Isoheptane/STM32F407V-Dev/board/STM32F407Dev.kicad_pcb

## KiCad design board/STM32F407Dev.kicad_pcb (2025-10-26)

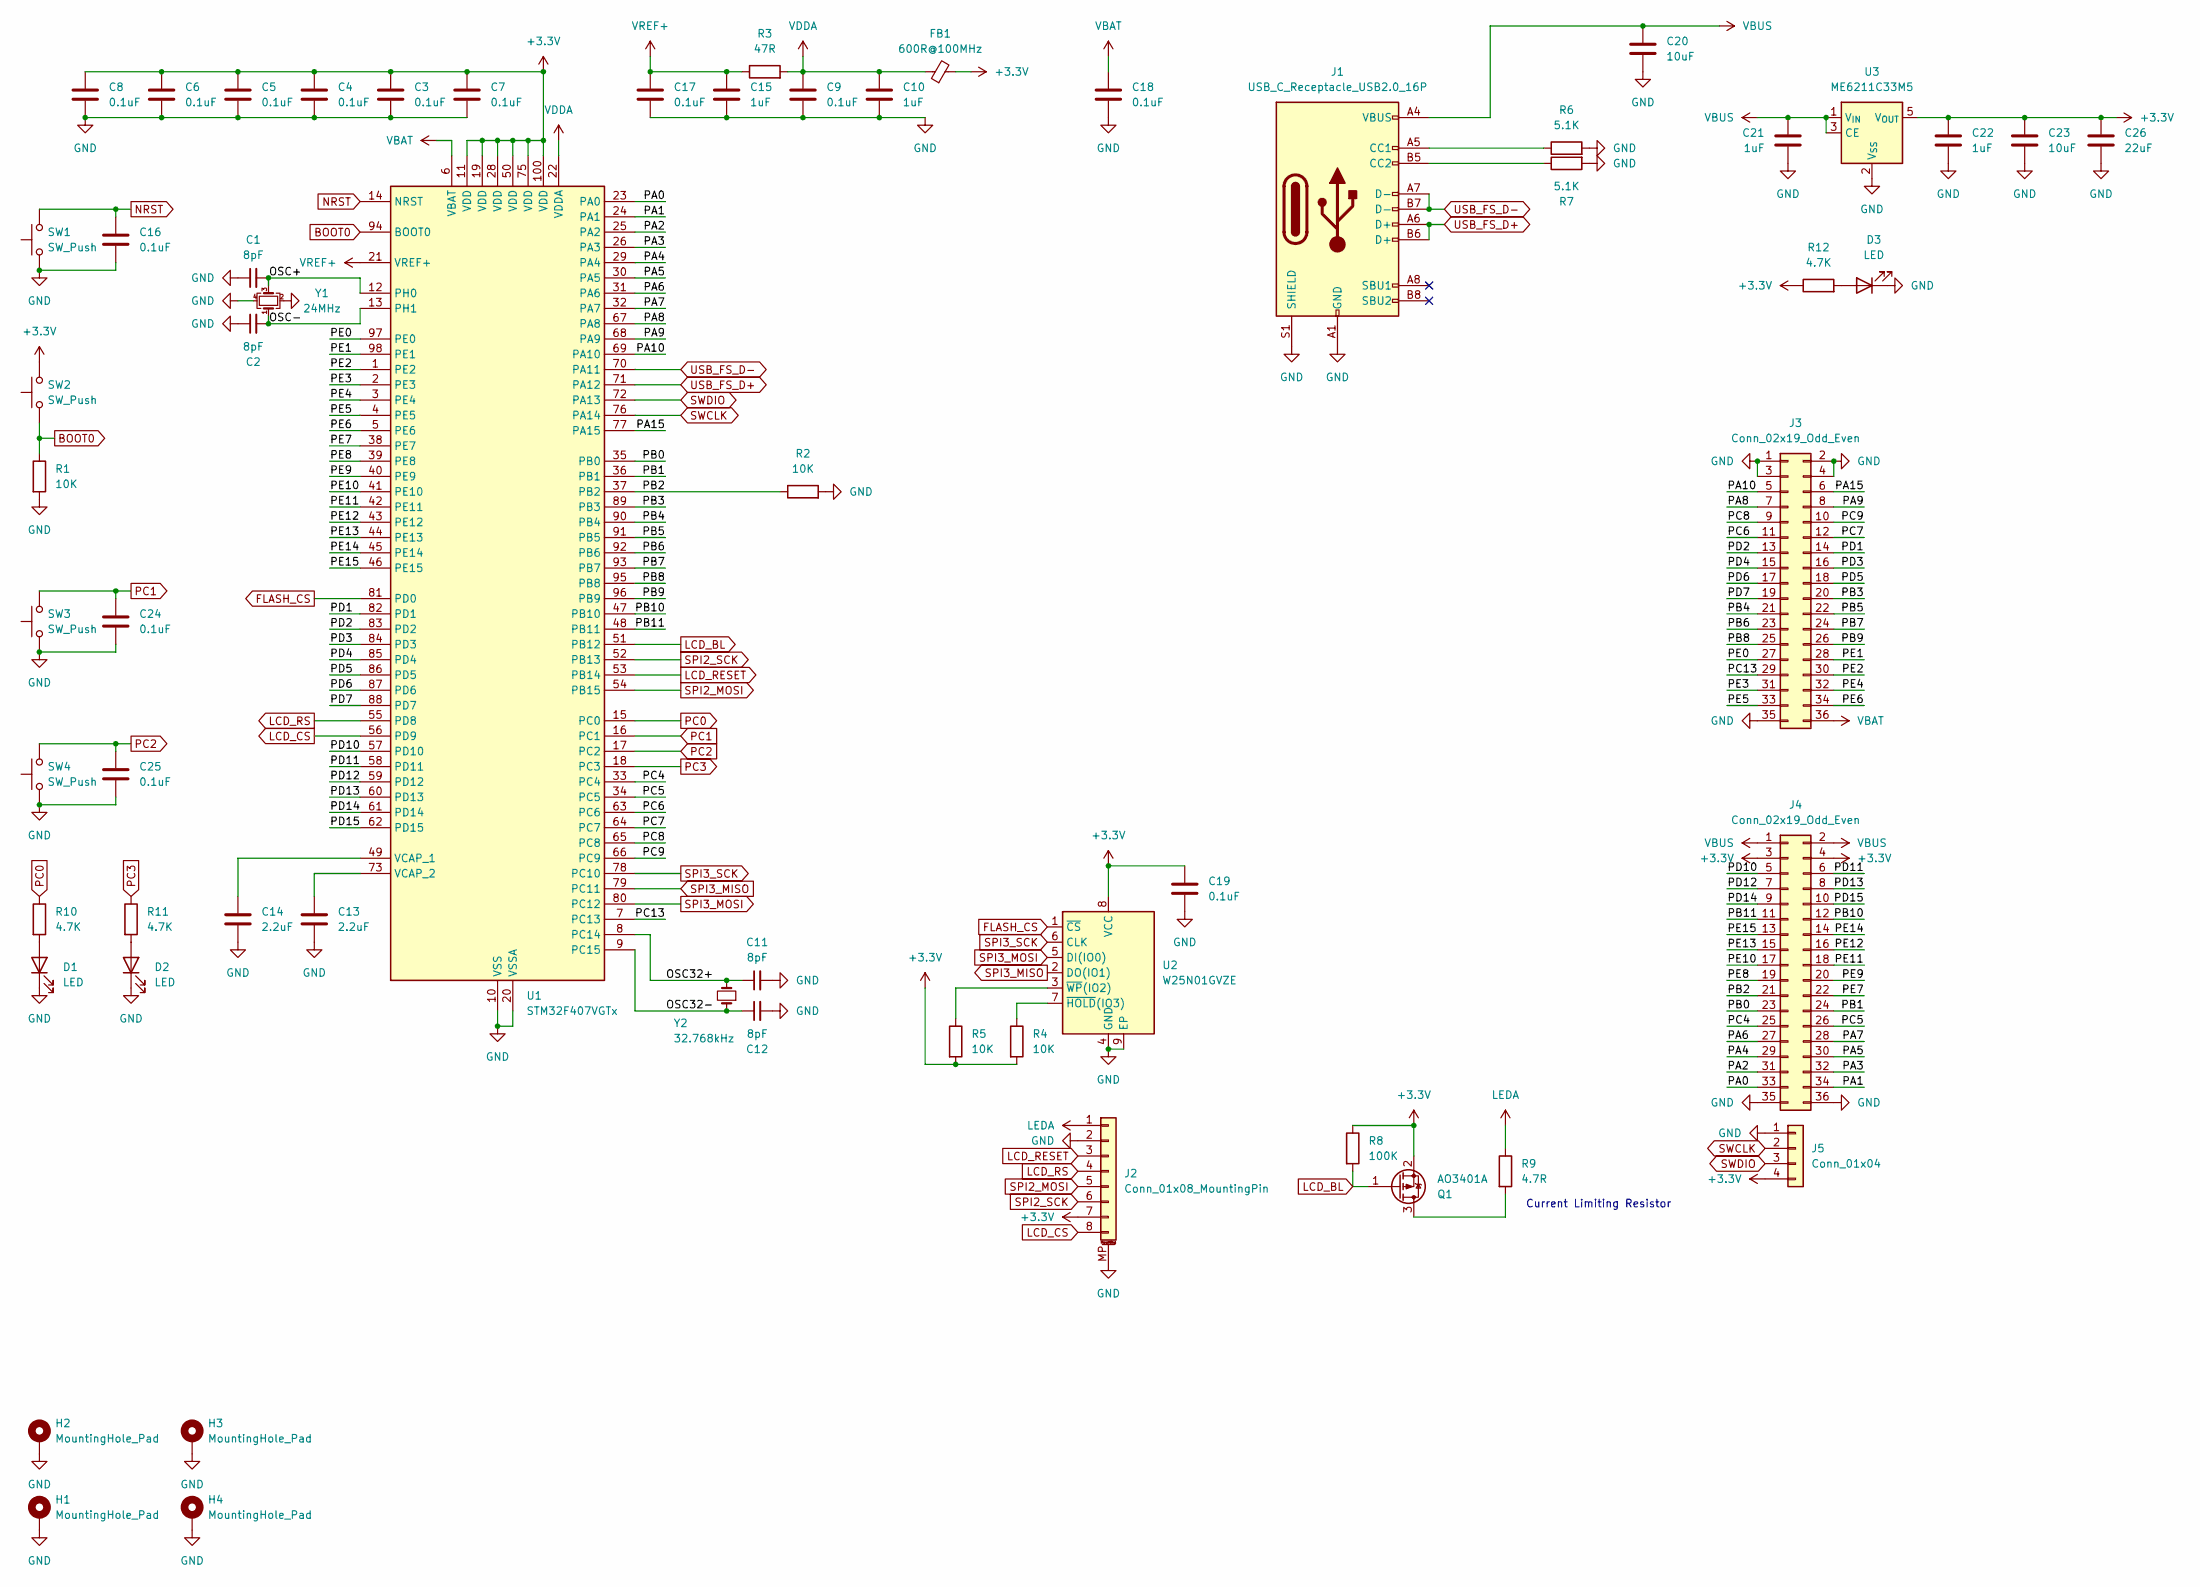
[picture p1: schematic STM32F407Dev.kicad_sch]

Parts:
C1, C2, C11, C12: 8pF; C_0402_1005Metric
C3, C4, C5, C6, C7, C8, C9, C16, C17, C18, C19, C24, C25: 0.1uF; C_0402_1005Metric
C10, C15: 1uF; C_0402_1005Metric
C13, C14: 2.2uF; C_0402_1005Metric
C20, C23: 10uF; C_0805_2012Metric
C21, C22: 1uF; C_0603_1608Metric
C26: 22uF; C_0805_2012Metric
D1, D2, D3: LED; LED_0603_1608Metric
FB1: 600R@100MHz; L_0603_1608Metric
H1, H2, H3, H4: MountingHole_Pad; MountingHole_2.2mm_M2_ISO7380_Pad
J1: USB_C_Receptacle_USB2.0_16P; USB_C_Receptacle_GCT_USB4105-xx-A_16P_TopMnt_Horizontal
J2: Conn_01x08_MountingPin; Hirose_FH12-8S-0.5SH_1x08-1MP_P0.50mm_Horizontal
J3, J4: Conn_02x19_Odd_Even; PinHeader_2x18_P2.54mm_Vertical
J5: Conn_01x04; PinHeader_1x04_P2.54mm_Vertical
Q1: AO3401A; SOT-23
R1, R2, R4, R5: 10K; R_0402_1005Metric
R3: 47R; R_0402_1005Metric
R6, R7: 5.1K; R_0402_1005Metric
R8: 100K; R_0402_1005Metric
R9: 4.7R; R_0402_1005Metric
R10, R11, R12: 4.7K; R_0402_1005Metric
SW1, SW2, SW3, SW4: SW_Push; SW_SPST_PTS810
U1: STM32F407VGTx; LQFP-100_14x14mm_P0.5mm
U2: W25N01GVZE; WSON-8-1EP_8x6mm_P1.27mm_EP3.4x4.3mm_WidePin
U3: ME6211C33M5; SOT-23-5
Y1: 24MHz; Crystal_SMD_3225-4Pin_3.2x2.5mm
Y2: 32.768kHz; Crystal_SMD_3215-2Pin_3.2x1.5mm

Connections:
+3.3V: C3.1, C4.1, C5.1, C6.1, C7.1, C8.1, C19.1, C22.1, C23.1, C26.1, FB1.2, J2.7, J4.3, J4.4, J5.4, Q1.2 (S), R4.2, R5.2, R8.1, R12.1, SW2.2, U1.11 (VDD), U1.19 (VDD), U1.28 (VDD), U1.50 (VDD), U1.75 (VDD), U1.100 (VDD), U2.8 (VCC), U3.5 (V_{OUT})
/OSC32+: C11.1, U1.8 (PC14), Y2.2
/OSC32-: C12.1, U1.9 (PC15), Y2.1
/OSC+: C1.2, U1.12 (PH0), Y1.3
/OSC-: C2.2, U1.13 (PH1), Y1.1
/PA0: J4.33, U1.23 (PA0)
/PA1: J4.34, U1.24 (PA1)
/PA2: J4.31, U1.25 (PA2)
/PA3: J4.32, U1.26 (PA3)
/PA4: J4.29, U1.29 (PA4)
/PA5: J4.30, U1.30 (PA5)
/PA6: J4.27, U1.31 (PA6)
/PA7: J4.28, U1.32 (PA7)
/PA8: J3.7, U1.67 (PA8)
/PA9: J3.8, U1.68 (PA9)
/PA10: J3.5, U1.69 (PA10)
/PA15: J3.6, U1.77 (PA15)
/PB0: J4.23, U1.35 (PB0)
/PB1: J4.24, U1.36 (PB1)
/PB2: J4.21, R2.1, U1.37 (PB2)
/PB3: J3.20, U1.89 (PB3)
/PB4: J3.21, U1.90 (PB4)
/PB5: J3.22, U1.91 (PB5)
/PB6: J3.23, U1.92 (PB6)
/PB7: J3.24, U1.93 (PB7)
/PB8: J3.25, U1.95 (PB8)
/PB9: J3.26, U1.96 (PB9)
/PB10: J4.12, U1.47 (PB10)
/PB11: J4.11, U1.48 (PB11)
/PC4: J4.25, U1.33 (PC4)
/PC5: J4.26, U1.34 (PC5)
/PC6: J3.11, U1.63 (PC6)
/PC7: J3.12, U1.64 (PC7)
/PC8: J3.9, U1.65 (PC8)
/PC9: J3.10, U1.66 (PC9)
/PC13: J3.29, U1.7 (PC13)
/PD1: J3.14, U1.82 (PD1)
/PD2: J3.13, U1.83 (PD2)
/PD3: J3.16, U1.84 (PD3)
/PD4: J3.15, U1.85 (PD4)
/PD5: J3.18, U1.86 (PD5)
/PD6: J3.17, U1.87 (PD6)
/PD7: J3.19, U1.88 (PD7)
/PD10: J4.5, U1.57 (PD10)
/PD11: J4.6, U1.58 (PD11)
/PD12: J4.7, U1.59 (PD12)
/PD13: J4.8, U1.60 (PD13)
/PD14: J4.9, U1.61 (PD14)
/PD15: J4.10, U1.62 (PD15)
/PE0: J3.27, U1.97 (PE0)
/PE1: J3.28, U1.98 (PE1)
/PE2: J3.30, U1.1 (PE2)
/PE3: J3.31, U1.2 (PE3)
/PE4: J3.32, U1.3 (PE4)
/PE5: J3.33, U1.4 (PE5)
/PE6: J3.34, U1.5 (PE6)
/PE7: J4.22, U1.38 (PE7)
/PE8: J4.19, U1.39 (PE8)
/PE9: J4.20, U1.40 (PE9)
/PE10: J4.17, U1.41 (PE10)
/PE11: J4.18, U1.42 (PE11)
/PE12: J4.16, U1.43 (PE12)
/PE13: J4.15, U1.44 (PE13)
/PE14: J4.14, U1.45 (PE14)
/PE15: J4.13, U1.46 (PE15)
BOOT0: R1.1, SW2.1, U1.94 (BOOT0)
FLASH_CS: U1.81 (PD0), U2.1 (~CS)
GND: C1.1, C2.1, C3.2, C4.2, C5.2, C6.2, C7.2, C8.2, C9.2, C10.2, C11.2, C12.2, C13.2, C14.2, C15.2, C16.2, C17.2, C18.2, C19.2, C20.2, C21.2, C22.2, C23.2, C24.2, C25.2, C26.2, D1.1 (K), D2.1 (K), D3.1 (K), H1.1, H2.1, H3.1, H4.1, J1.A1 (GND), J1.A12 (GND), J1.B1 (GND), J1.B12 (GND), J1.S1 (SHIELD), J2.2, J2.MP (MountPin), J3.1, J3.2, J3.3, J3.4, J3.35, J4.35, J4.36, J5.1, R1.2, R2.2, R6.2, R7.2, SW1.1, SW3.1, SW4.1, U1.10 (VSS), U1.20 (VSSA), U1.27 (VSS), U1.74 (VSS), U1.99 (VSS), U2.4 (GND), U2.9 (EP), U3.2 (V_{SS}), Y1.2, Y1.4
LCD_BL: Q1.1 (G), R8.2, U1.51 (PB12)
LCD_CS: J2.8, U1.56 (PD9)
LCD_RESET: J2.3, U1.53 (PB14)
LCD_RS: J2.4, U1.55 (PD8)
LEDA: J2.1, R9.1
NRST: C16.1, SW1.2, U1.14 (NRST)
unnamed: D1.2 (A), R10.2
unnamed: D2.2 (A), R11.2
unnamed: D3.2 (A), R12.2
unnamed: J1.A5 (CC1), R6.1
unnamed: J1.B5 (CC2), R7.1
unnamed: Q1.3 (D), R9.2
unnamed: C14.1, U1.49 (VCAP_1)
unnamed: C13.1, U1.73 (VCAP_2)
unnamed: R4.1, U2.7 (~HOLD(IO3))
unnamed: R5.1, U2.3 (~WP(IO2))
PC0: R10.1, U1.15 (PC0)
PC1: C24.1, SW3.2, U1.16 (PC1)
PC2: C25.1, SW4.2, U1.17 (PC2)
PC3: R11.1, U1.18 (PC3)
SPI2_MOSI: J2.5, U1.54 (PB15)
SPI2_SCK: J2.6, U1.52 (PB13)
SPI3_MISO: U1.79 (PC11), U2.2 (DO(IO1))
SPI3_MOSI: U1.80 (PC12), U2.5 (DI(IO0))
SPI3_SCK: U1.78 (PC10), U2.6 (CLK)
SWCLK: J5.2, U1.76 (PA14)
SWDIO: J5.3, U1.72 (PA13)
USB_FS_D+: J1.A6 (D+), J1.B6 (D+), U1.71 (PA12)
USB_FS_D-: J1.A7 (D-), J1.B7 (D-), U1.70 (PA11)
VBAT: C18.1, J3.36, U1.6 (VBAT)
VBUS: C20.1, C21.1, J1.A4 (VBUS), J1.A9 (VBUS), J1.B4 (VBUS), J1.B9 (VBUS), J4.1, J4.2, U3.1 (V_{IN}), U3.3 (CE)
VDDA: C9.1, C10.1, FB1.1, R3.2, U1.22 (VDDA)
VREF+: C15.1, C17.1, R3.1, U1.21 (VREF+)

Notes on the sheet:
Current Limiting Resistor

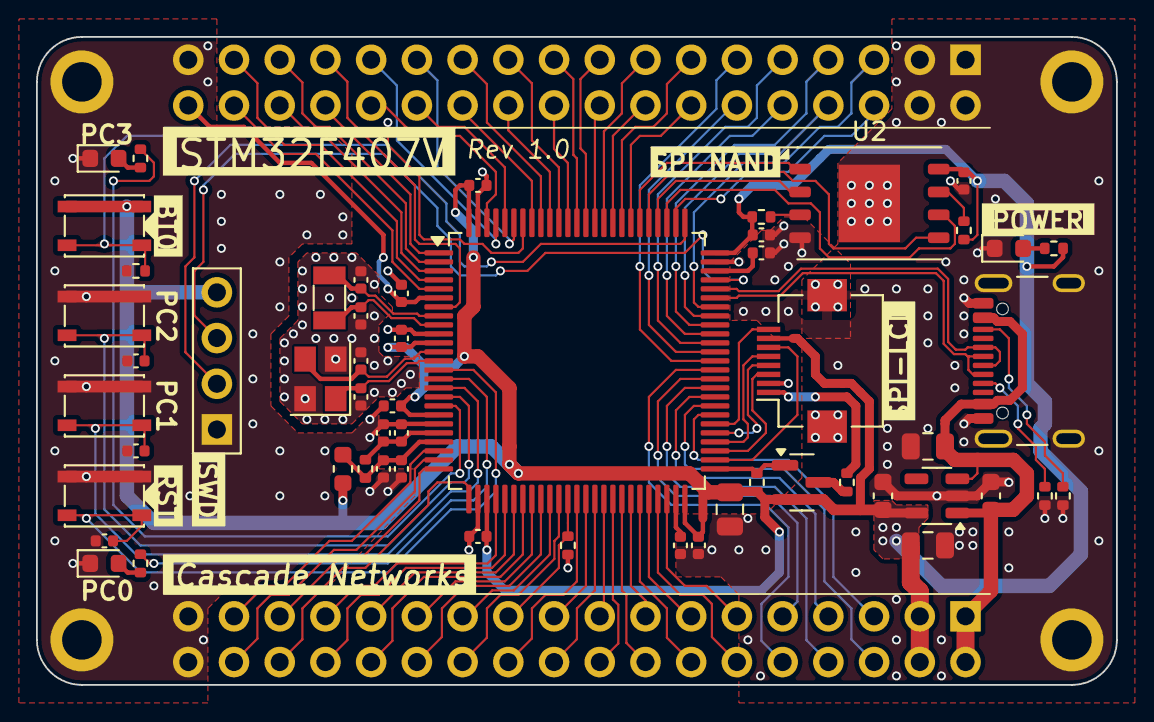
[picture p2: board STM32F407Dev.kicad_pcb from above]

Board: 2 copper layers, 60.0 x 36.0 mm, 61 parts (0 on the bottom side), 101 nets.
