Isoheptane/STM32F407V-Dev/(commit log)

2024-11-13 Update STM32F407Dev Board Design Files
    [STM32F407Dev.kicad_pcb, STM32F407Dev.kicad_sch]
2024-11-13 Board: Move Board Design Files
    [STM32F407Dev.kicad_pcb, STM32F407Dev.kicad_sch]
2025-10-26 Update STM32F407 file, delete backup and lock
    [STM32F407Dev.kicad_pcb, STM32F407Dev.kicad_sch]
